poorhouse/p0003/out/Generate Files/DiffReport/PCB1.html

Altium

# Differences Report for Project p0001.PrjPcb and PCB1.PcbDoc

Date | : | 10/31/2014
Time | : | 12:24:05 PM
Filename | : | C:\Users\jeremy.hale\Documents\poorhouse-beta-elec-p0001\design\poorhouse-beta-elec-p0001\out\Generate Files\DiffReport\PCB1.html

## No differences were detected.

Back to top
