poorhouse/p0003/out/PDF/PCB Print/Assembly Drawings.PDF

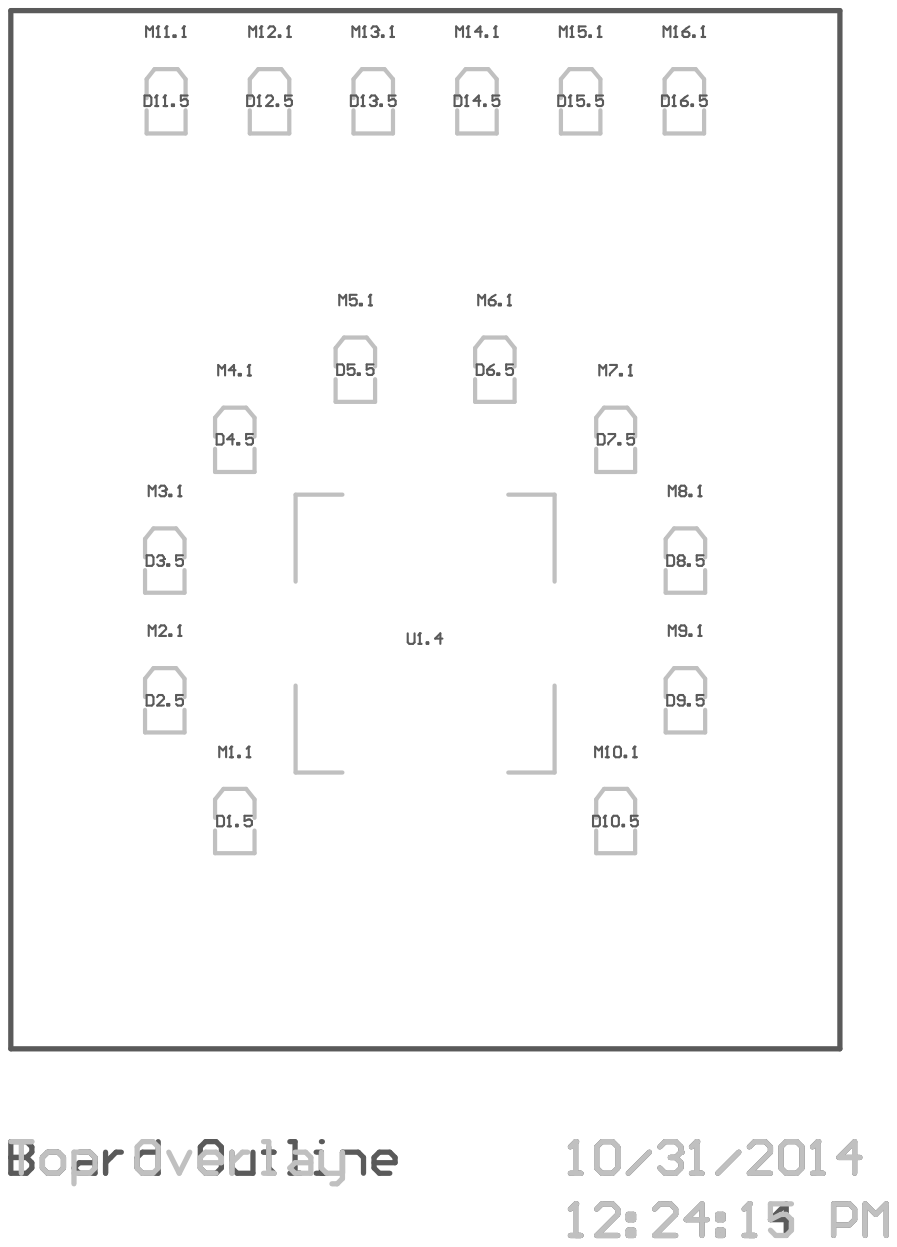
[picture p1: page 1]

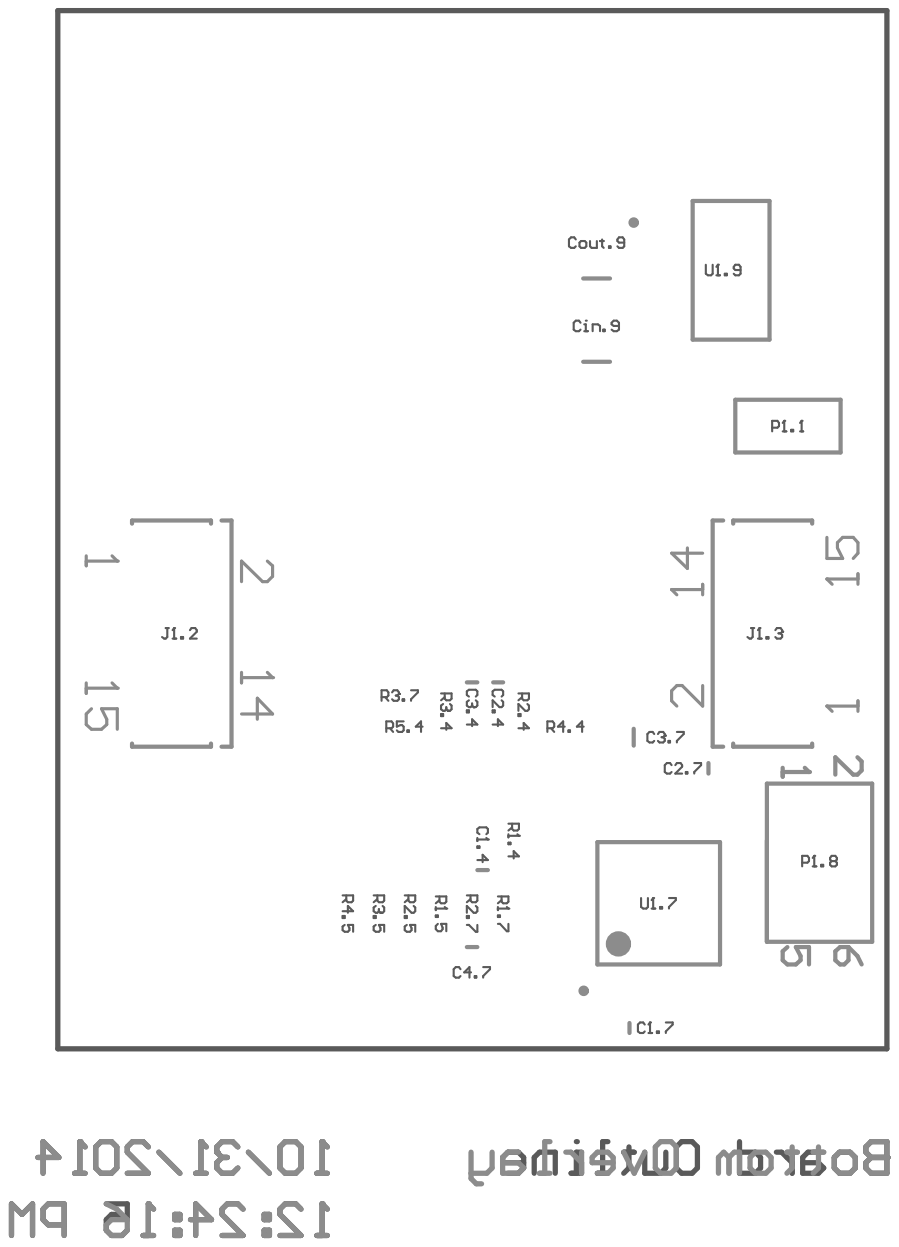
[picture p2: page 2]
