poorhouse/p0003/out/PDF/PCB Print/Drill Drawing_Guides.PDF

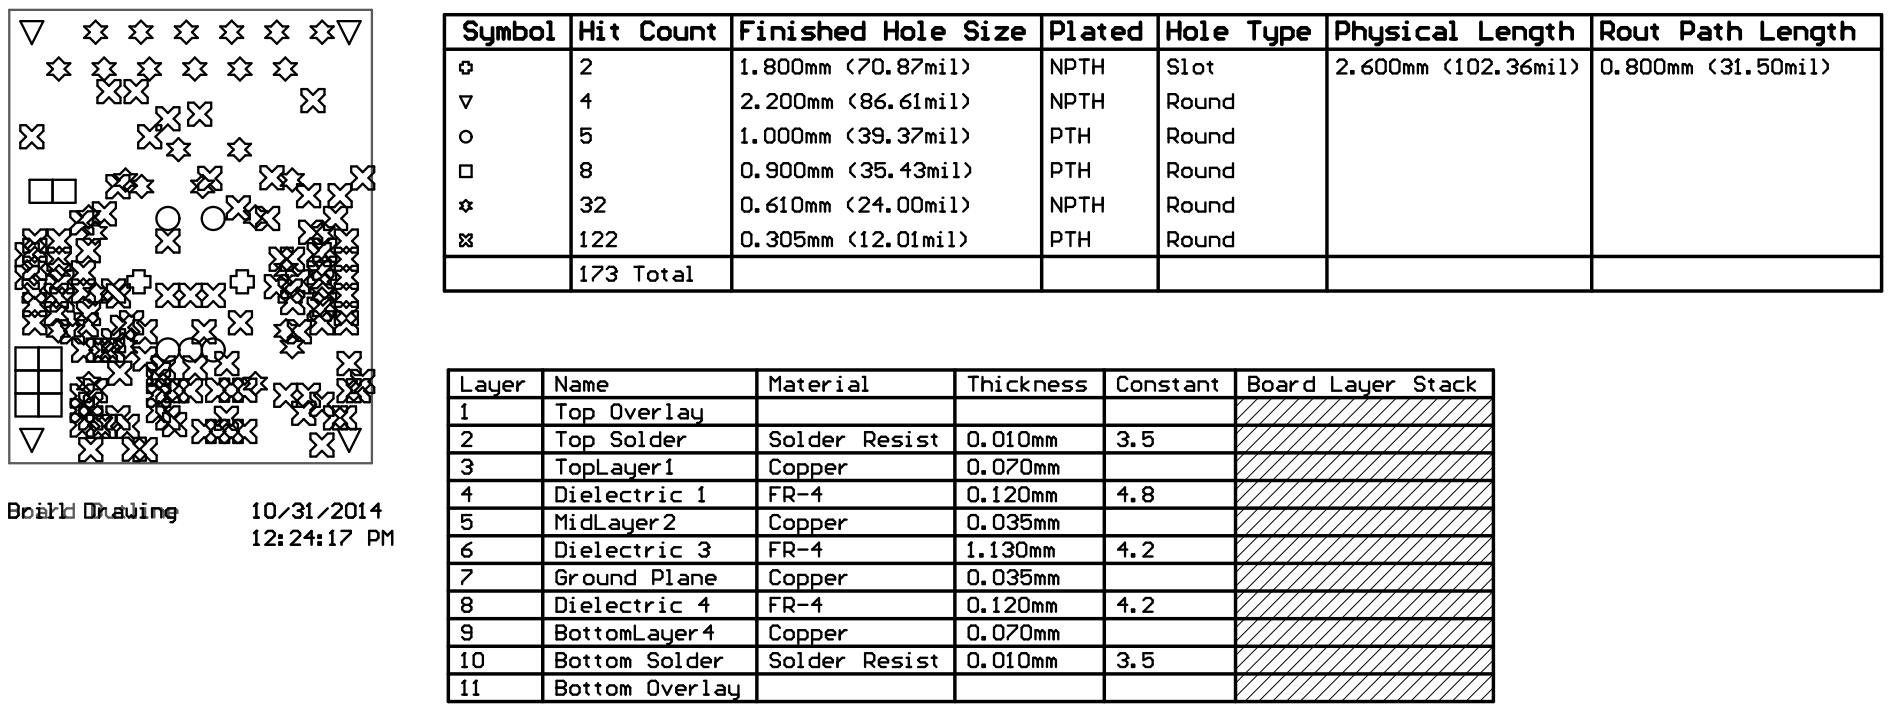
[picture p3: page 1]

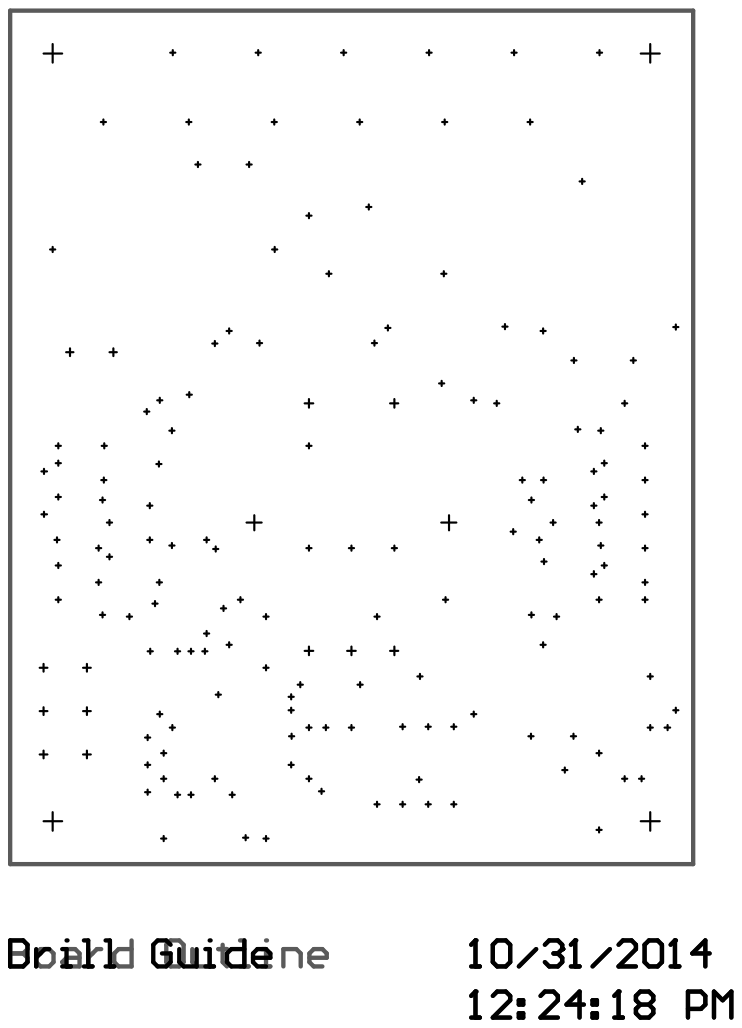
[picture p4: page 2]
