poorhouse/p0003/out/PDF/Schematic Print/Schematic Prints.PDF

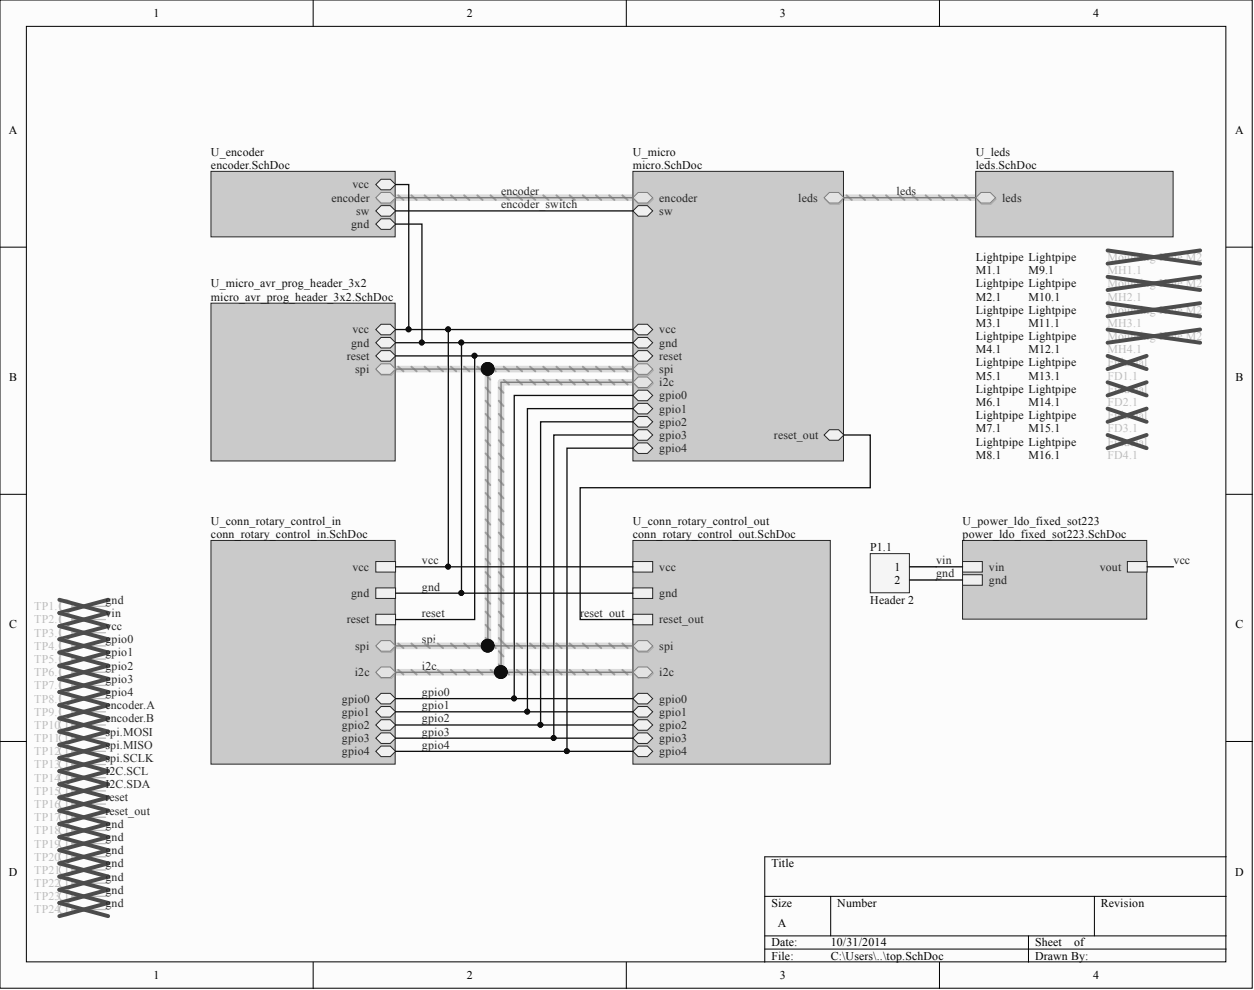
[picture p5: page 1]
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

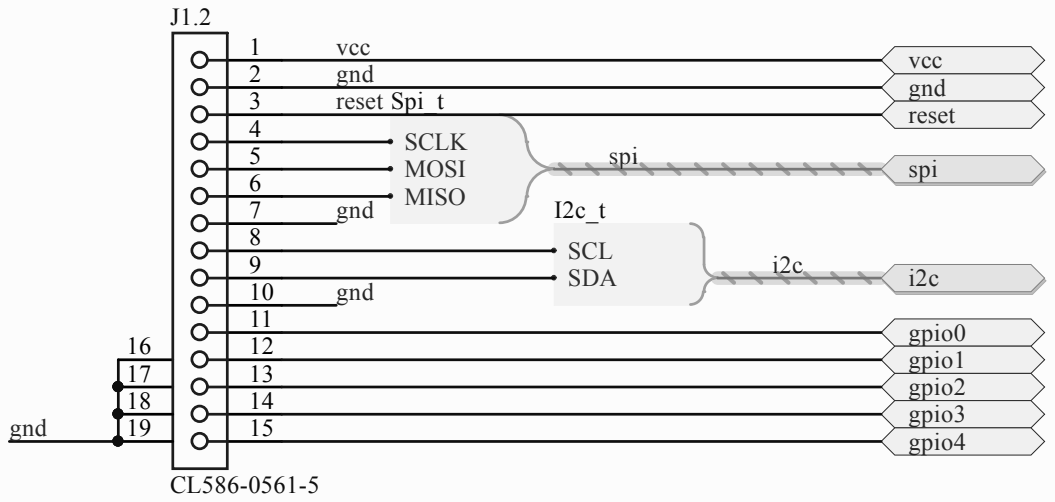
[picture p6: page 2]

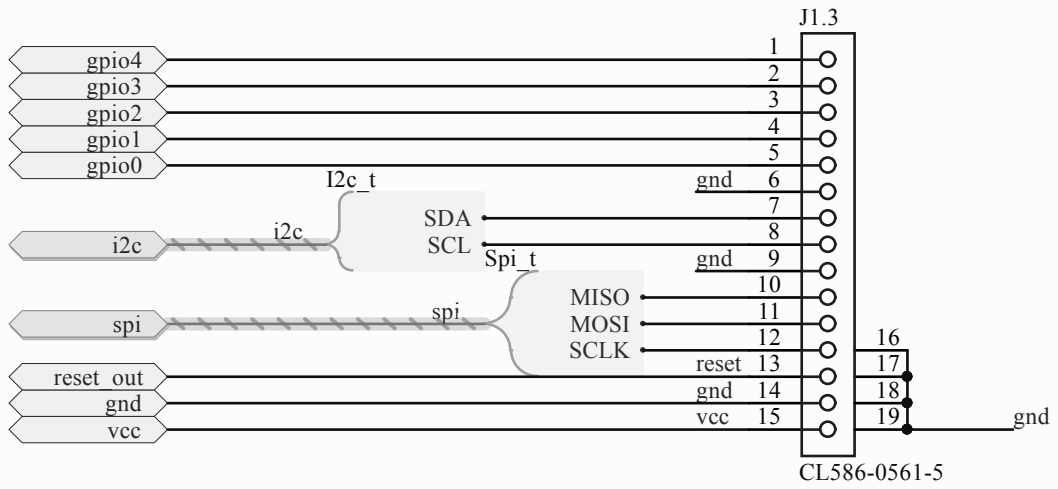
[picture p7: page 3]

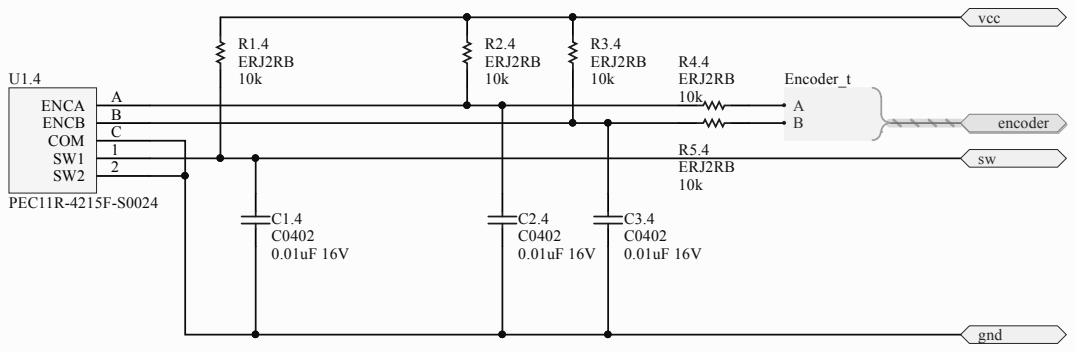
[picture p8: page 4]

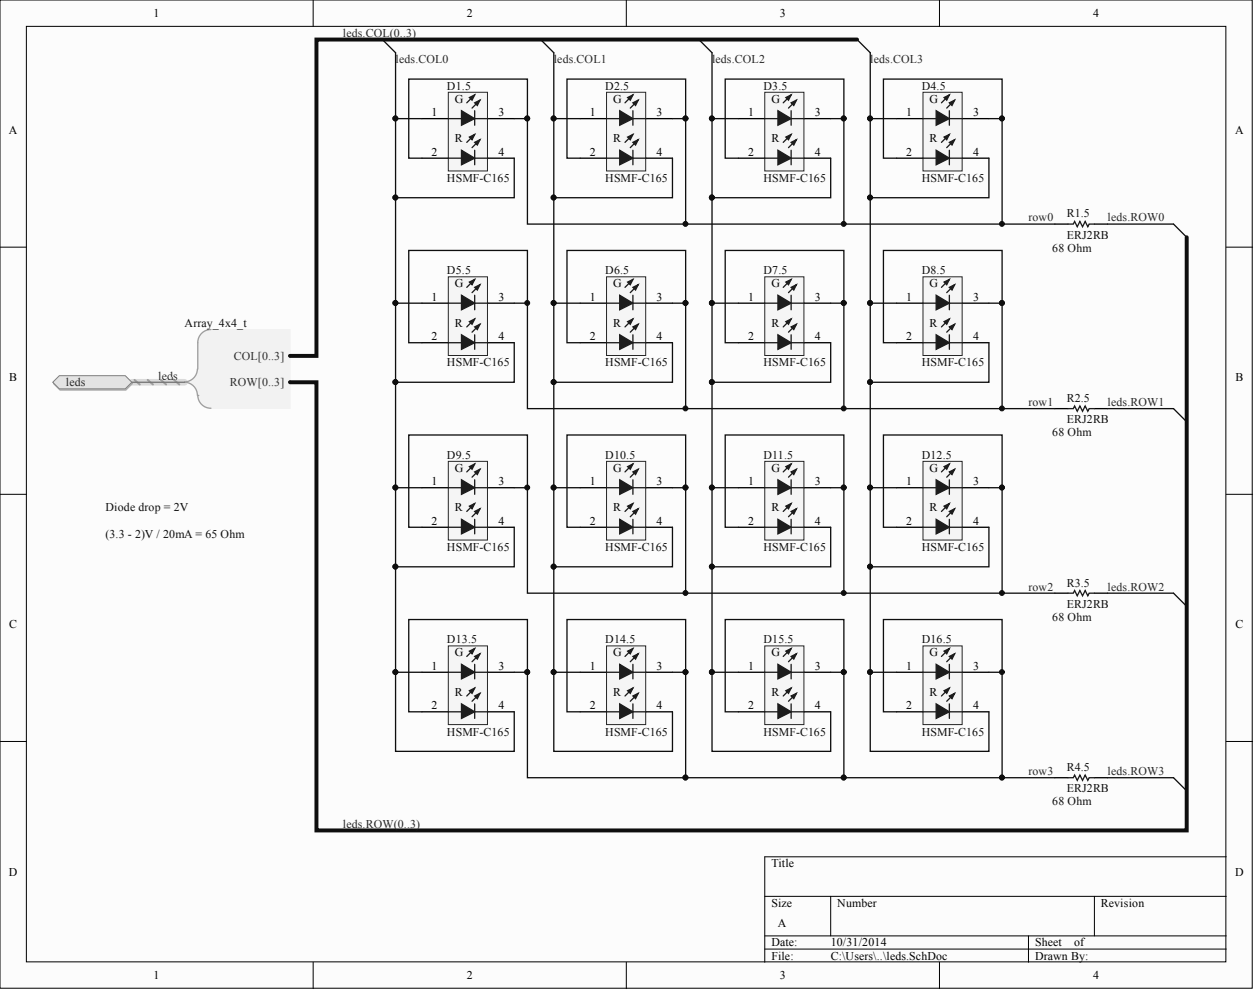
[picture p9: page 5]

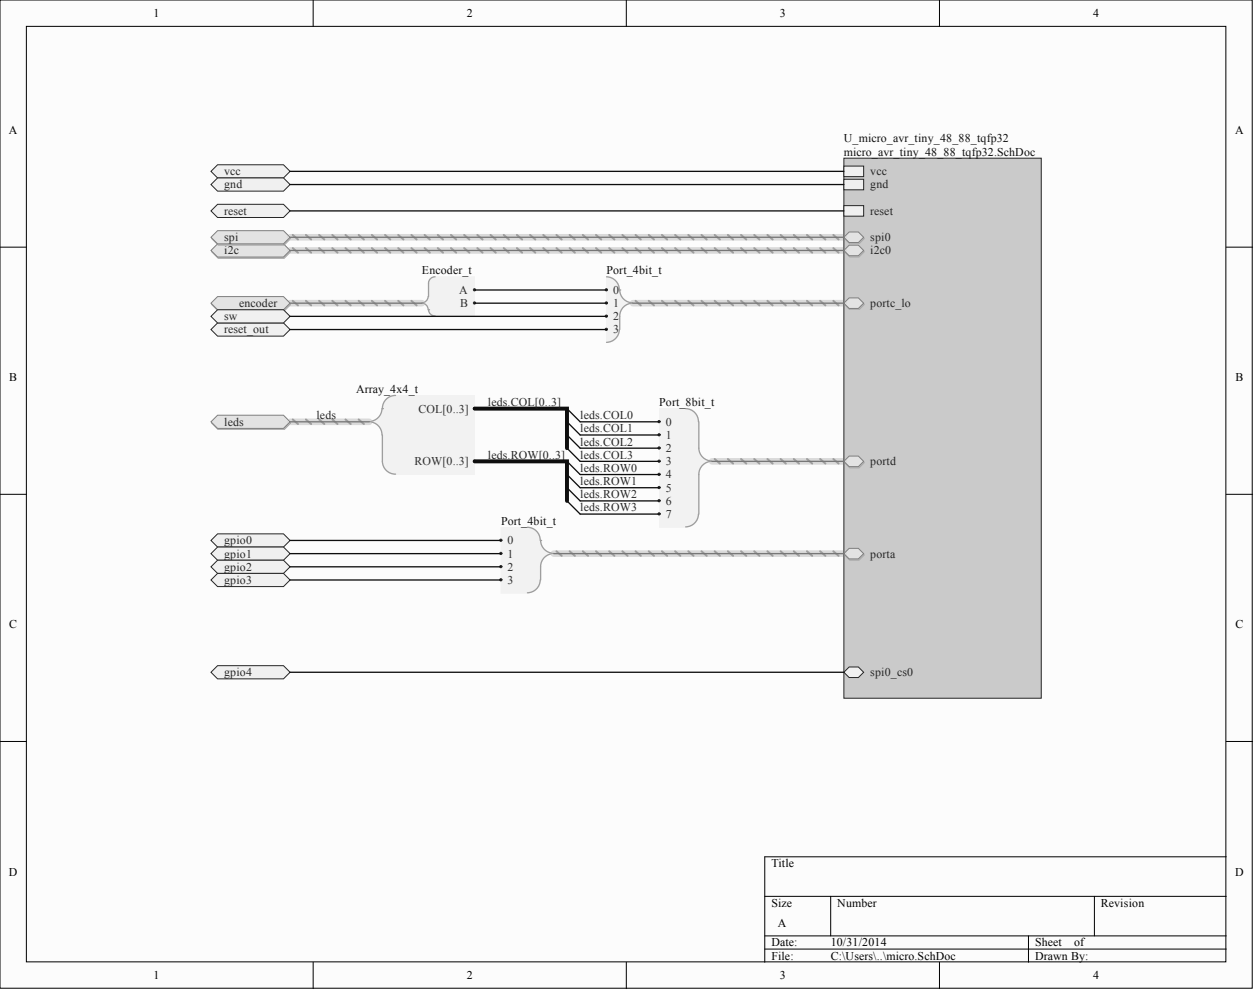
[picture p10: page 6]

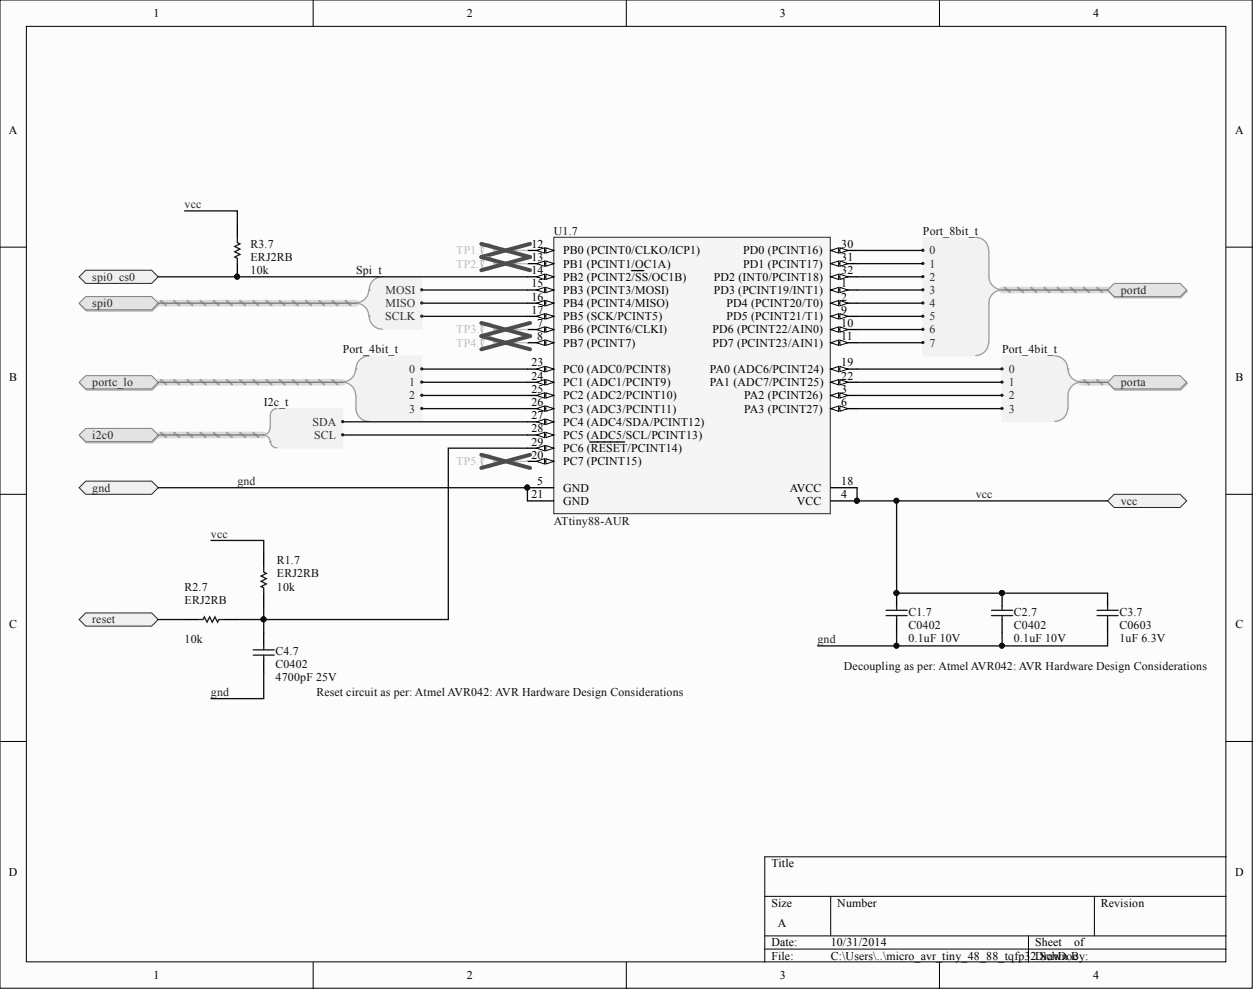
[picture p11: page 7]

2 1 | 4 | vcc

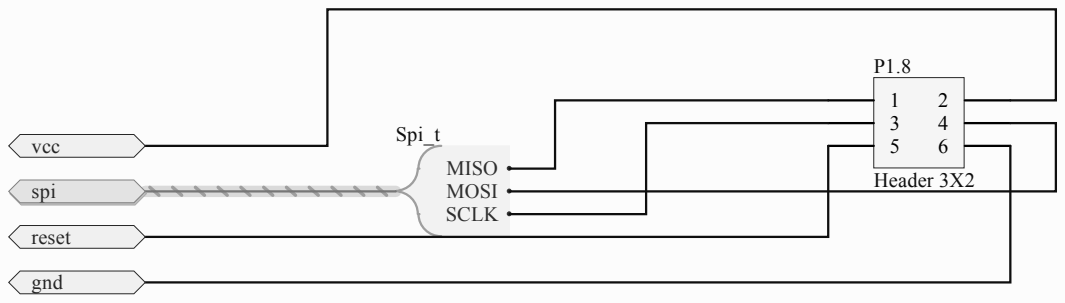
[picture p12: page 8]

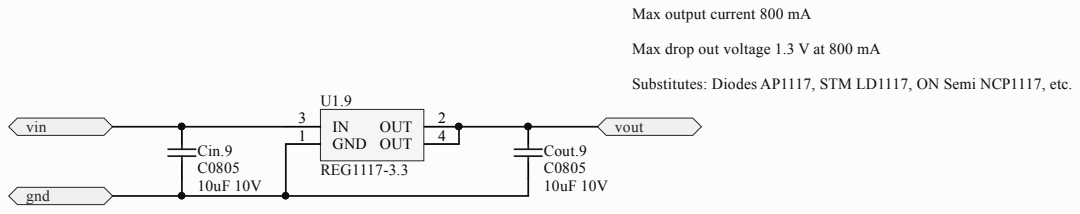
[picture p13: page 9]
