poorhouse/p0003/(list of files, drawings)

Other design files:
conn_rotary_control_in.SchDoc
conn_rotary_control_out.SchDoc
encoder.SchDoc
leds.SchDoc
micro.SchDoc
micro_avr_prog_header_3x2.SchDoc
micro_avr_tiny_48_88_tqfp32.SchDoc
p0001.PrjPcb
PCB1.PcbDoc
power_ldo_fixed_sot223.SchDoc
top.SchDoc
