poorhouse/p0003/(commit log)

2014-10-23 Initial commit.
    [encoder.SchDoc, leds.SchDoc, micro.SchDoc, micro_avr_prog_header_3x2.SchDoc, micro_avr_tiny_48_88_tqfp32.SchDoc, p0001.PrjPcb, top.SchDoc]
2014-10-23 Minor work.
    [leds.SchDoc, micro.SchDoc, micro_avr_prog_header_3x2.SchDoc, micro_avr_tiny_48_88_tqfp32.SchDoc, p0001.PrjPcb, top.SchDoc]
2014-10-23 added board level annotation.
    [leds.SchDoc, micro_avr_tiny_48_88_tqfp32.SchDoc, p0001.PrjPcb]
2014-10-24 Connected SPI slave select pin to VCC. Only using SPI for programming.
    [micro.SchDoc, top.SchDoc]
2014-10-24 added reset output annotating by sheet number
    [micro.SchDoc, p0001.PrjPcb, top.SchDoc]
2014-10-24 Added flat flex connectors
    [conn_rotary_control_in.SchDoc, conn_rotary_control_out.SchDoc, micro.SchDoc, micro_avr_prog_header_3x2.SchDoc, micro_avr_tiny_48_88_tqfp32.SchDoc, p0001.PrjPcb, top.SchDoc]
2014-10-24 Updated schematic to use Avago HSMF-C165 bi-colour LEDs.
    [leds.SchDoc]
2014-10-24 Added Bourns rotary encoder to encoder sheet. Updated encoder sheet to use gnd port and only harness to be a/b signals. Updates designators. Added Bourns lib to project.
    [encoder.SchDoc, micro.SchDoc, p0001.PrjPcb, top.SchDoc]
2014-10-24 Added schematic for LDO. Added LDO to top sheet. Updated designators.
    [p0001.PrjPcb, power_ldo_fixed_sot223.SchDoc, top.SchDoc]
2014-10-24 Added 2 pin header for applying power.
    [top.SchDoc]
2014-10-24 Updated from libraries Added test points Update designators
    [conn_rotary_control_in.SchDoc, conn_rotary_control_out.SchDoc, encoder.SchDoc, leds.SchDoc, micro.SchDoc, micro_avr_prog_header_3x2.SchDoc, micro_avr_tiny_48_88_tqfp32.SchDoc, p0001.PrjPcb]
2014-10-24 Added PCB file Placed rotary encoder Placed LEDs
    [PCB1.PcbDoc, p0001.PrjPcb]
2014-10-25 Adding extra harness definition file because altium is stoopid
    [p0001.PrjPcb]
2014-10-25 Components arranged in rooms.
    [PCB1.PcbDoc]
2014-10-25 Updated rules.
    [PCB1.PcbDoc]
2014-10-25 Layout for LEDs partial.
    [PCB1.PcbDoc]
2014-10-25 Changed connector from horizontal to vertical.
    [conn_rotary_control_in.SchDoc, conn_rotary_control_out.SchDoc]
2014-10-25 Reduced LED circle to 13 mm from 15 mm. Defined board size as 4 cm by 4 cm.
    [PCB1.PcbDoc]
2014-10-25 Placed flat flex connectors 15 mm from center.
    [PCB1.PcbDoc]
2014-10-25 Some issues with naming LED nets.
    [leds.SchDoc, micro.SchDoc, top.SchDoc]
2014-10-25 Placed AVR programming connector.
    [PCB1.PcbDoc]
2014-10-26 Updated from libraries. Changed rotary encoder to version with switch. Added res/caps to rotary encoder circuit. Annotated.
    [conn_rotary_control_in.SchDoc, conn_rotary_control_out.SchDoc, encoder.SchDoc, leds.SchDoc, micro.SchDoc, micro_avr_prog_header_3x2.SchDoc, micro_avr_tiny_48_88_tqfp32.SchDoc, p0001.PrjPcb]
2014-10-26 Moved 'reset out' from port c 2 to port c 3. Connected encoder switch to port c 2.
    [micro.SchDoc, top.SchDoc]
2014-10-26 Added light pipes to top
    [p0001.PrjPcb, top.SchDoc]
2014-10-26 After trying to put 15, then 12, then 11, then 10 light pipes on a 270 degree, 13 mm arc and not having enough room, I've switched to a 300 degree arc. This is the same rotation as a normal resistive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
    [PCB1.PcbDoc, top.SchDoc]
2014-10-27 LEDs and light pipes placed on 13 mm radius with 10 spaced over 300 degrees.
    [PCB1.PcbDoc]
2014-10-27 Updated stack-up to 4 layer with 1 ground plane, 1.6 mm thick.
    [PCB1.PcbDoc]
2014-10-27 Swap SPI lines on connector for easier routing. Routing for SPI, I2C, and between connectors.
    [PCB1.PcbDoc, conn_rotary_control_in.SchDoc, conn_rotary_control_out.SchDoc, p0001.PrjPcb]
2014-10-27 Added output job file.
    [p0001.PrjPcb]
2014-10-27 Added space for 6 LED across top of PCB. Extended length of PCB to 60 mm.
    [PCB1.PcbDoc, top.SchDoc]
2014-10-27 Updated encoder sheet with symbol with non plated holes. Fixed some library references.
    [encoder.SchDoc, p0001.PrjPcb]
2014-10-27 90% is finished. Vcc, test points and voltage regulator not routed.
    [PCB1.PcbDoc]
2014-10-27 Initial routing mostly complete.
    [PCB1.PcbDoc]
2014-10-27 Added 4 mounting holes M2. everything except for test points is routed.
    [PCB1.PcbDoc, p0001.PrjPcb, top.SchDoc]
2014-10-28 Added 4 fiducials. Added polygon pours. Initial routing complete - need to do clean up.
    [PCB1.PcbDoc, p0001.PrjPcb, top.SchDoc]
2014-10-29 Added values and part numbers to parts. Updated outjob file to make csv instead of xls. Cleaned up routing. Connectors ground nets are direct connect.
    [PCB1.PcbDoc, conn_rotary_control_in.SchDoc, conn_rotary_control_out.SchDoc, encoder.SchDoc, leds.SchDoc, micro_avr_tiny_48_88_tqfp32.SchDoc, p0001.PrjPcb, power_ldo_fixed_sot223.SchDoc]
2014-10-30 Minor tweaks to routing. Minor tweaks to outjob file. Reviewed files. Committing outputs.
    [Bill of Materials-p0001(Variant of p0001).csv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]
2014-10-30 Adding schematic print to out job as well.
2014-10-30 Removed designator layers from drill prints.
2014-10-30 Increased clearance for copper to non plated holes for both inner and outer layers. Adjusted layout for increased clearance.
    [PCB1.PcbDoc, p0001.PrjPcb]
2014-10-30 Added clearance rule for gnd vias and other holes to prevent thin copper areas on ground plane. Update layout accordingly.
    [PCB1.PcbDoc]
2014-10-31 Increased solder mask clearance to 0.003" from 0.002". And, re-generated all output files.
    [PCB1.PcbDoc]
2014-10-31 Increase via hole size to 0.305 mm from 0.3 mm. Created rule for min hole size 0.305 mm. Putting board outline on separate layer.
    [PCB1.PcbDoc]
2014-10-31 Added part number with 'a' version.
    [PCB1.PcbDoc]
2014-10-31 Generated output.
    [PCB1.GBL, PCB1.GBO, PCB1.GBP, PCB1.GBS, PCB1.GTL, PCB1.GTO, PCB1.GTP, PCB1.GTS]
2014-10-31 Added layer name to Board Outline.
    [PCB1.PcbDoc]
2014-10-31 Renamed board outline to GML from GM6 as per dirtypcbs.com requirement.
